Satianpong-Ded/Hydroponic_PCB/Hardware/BOM_Hydroponic.csv

ID | Name | Designator | Footprint | Quantity | Manufacturer Part | Manufacturer | Supplier | Supplier Part | Price
1 | 19-217/R6C-AL1M2VY/3T | LED1 | LED0603-RD | 1 | 19-217/R6C-AL1M2VY/3T | EVERLIGHT(亿光) | LCSC | C72044 | 0.021
2 | 10uF | C2,C5,C10 | CAP-TH_BD5.0-P2.00-D0.8-FD | 3 | 50YXF10MEFC5X11 | rubycon(红宝石) | LCSC | C88726 | 0.052
3 | 1uF | C11 | CAP-TH_BD5.0-P2.00-D0.8-FD | 1 | 50YXF10MEFC5X11 | rubycon(红宝石) | LCSC | C88726 | 0.052
4 | LED-TH-3mm_B | LED_B | LED-TH_BD3.0_BLUE | 1 | 204-10SUBC/S400-A4 | EVERLIGHT(台湾亿光) | LCSC | C86881 | 0.045
5 | CONN-TH_2P-P5.00 | RELAY_IN,12V_IN | CONN-TH_2P-P5.00 | 2 |  |  | LCSC
6 | 1uF | C4,C6,C8 | CAP-TH_L8.5-W5.0-P5.00-D1.2 | 3 | CT4-0805B105K500F3 | FH(风华) | LCSC | C94708 | 0.09
7 | 10uF | C7,C9 | CAP-TH_L5.5-W3.8-P5.08-D0.5 | 2 | CD1E106MC9BER2F100 | Dersonic(德尔创) | LCSC | C2761733 | 0.416
8 | 104 | CX1,CX2,CX3,CX4,CX5,CX6,CX7 | RAD-0.1 | 7 |  |  | YUJING
9 | 1N4007G_C232439 | D5,D6 | DO-41_BD2.4-L4.7-P8.70-D0.9-RD | 2 | 1N4007G | onsemi(安森美) | LCSC | C232439 | 0.057
10 | HDR-F-2.54_1x4 | DHT22 | HDR-F-2.54_1X4 | 1 |  |  | LCSC | C225501 | 0.098
11 | 2N3904BU | Q5,Q6 | TO-92-3_L5.1-W4.1-P1.27-L | 2 | 2N3904BU | onsemi(安森美) | LCSC | C124482 | 0.102
12 | 1k | R2,R10,R12,R13,R18 | R0603 | 5
13 | 51k | R4,R29 | R0603 | 2
14 | 10k | R7,R11,R19,R20,R22,R23,R24,R27,R28 | R0603 | 9
15 | 20k | R9,R25,R26 | R0603 | 3
16 | 100kΩ | R3 | RES-TH_BD2.3-L6.5-P10.50-D0.5 | 1 | MF1/4W-100KΩ±1% T | CCO(千志电子) | LCSC | C119369 | 0.011
17 | 1kΩ | R8,R21 | RES-TH_BD2.3-L6.5-P10.50-D0.5 | 2 | MF1/4W-1KΩ±1% T | CCO(千志电子) | LCSC | C119324 | 0.011
18 | 10kΩ | R14,R17 | RES-TH_BD2.3-L6.5-P10.50-D0.5 | 2 | MF1/4W-10KΩ±1% T | CCO(千志电子) | LCSC | C119347 | 0.011
19 | 470Ω | R15,R16 | RES-TH_BD2.3-L6.5-P10.50-D0.5 | 2 | MF1/2WS-470Ω±1% T | CCO(千志电子) | LCSC | C129899 | 0.011
20 | 5.1kΩ | R33,R36 | RES-TH_BD2.3-L6.5-P10.50-D0.5 | 2 | MF1/4W-5.1KΩ±1%T52 | 华星机电 | LCSC | C714010 | 0.01
21 | 220 | R6 | R_AXIAL-0.4 | 1
22 | 4.7kΩ | R30,R34,R37 | RES-TH_BD2.4-L6.3-P10.30-D0.6 | 3 | MFR-25FBF52-4K7 | YAGEO(国巨) | LCSC | C1371435 | 0.022
23 | 12kΩ | R31,R32,R35,R38 | RES-TH_BD2.2-L6.5-P10.50-D0.6 | 4 | MF1/4W-12KΩ±1% T | CCO(千志电子) | LCSC | C119349 | 0.011
24 | BNC-KYWE-295-W4-N | RF1 | BNC-TH_BNC-KYWE-295-W4-N | 1 | BNC-KYWE-295-W4-N | SAMZO(三佐) | LCSC | C41416668 | 1.567
25 | - | RLY5,RLY6 | RELAY-TH_SRD-XXVDC-XL-C | 2 | SRD-05VDC-SL-C | 松乐 | LCSC | C35449 | 0.446
26 | R_3386P_EU | RP1,RP2,RP3 | RES-ADJ-TH_3386P | 3 |  |  | LCSC
27 | VX7805-1000 voltage regulator | U1 | VX7805-1000 | 1 | VX7805-1000 | CUI | Digi-Key | 102-4253-ND
28 | AP2112K-3.3TRG1 | U4 | SOT-25-5_L2.9-W1.6-P0.95-LS2.8-BL | 1 | AP2112K-3.3TRG1 | DIODES(美台) | LCSC | C51118 | 0.179
29 | LTL17KRH5D-012A | U6,U7 | LED-TH_BD3.8-P2.54-RD-RED | 2 | LTL17KRH5D-012A | LITEON(光宝) | LCSC | C7435538 | 0.035
30 | TL431ACLPRE3 | U11 | TO-92-3_L4.8-W3.7-P1.27-L | 1 | TL431ACLPRE3 | TI(德州仪器) | LCSC | C2156646
31 | 100nF | U14,U16 | CAP-TH_L5.8-W2.8 | 2 | CC1H104MC1FD3F6C10SA | Dersonic(德尔创) | LCSC | C5375966 | 0.027
32 | ESP32-S3-WROOM-1(N8R2) | U15 | WIRELM-SMD_ESP32-S3-WROOM-1 | 1 | ESP32-S3-WROOM-1-N8R2 | ESPRESSIF(乐鑫) | LCSC | C2913204 | 4.678
33 | - | USB1 | USB-C-TH_TYPEC-306DDW-ARP16 | 1 | TYPEC-306DDW-ARP16 | XUNPU(讯普) | LCSC | C2840393 | 0.852
34 | TLV2372IDGKG4 | U2,U5,U8,U9,U10,U13 | VSSOP-8_L3.0-W3.0-P0.65-LS5.0-BL | 6 | TLV2372IDGKG4 | TI(德州仪器) | LCSC | C1347919 | 1.795
35 | SH-6X6X8H-CJ | BOOT,RESET | SW-TH_4P-L6.0-W6.0-P4.50-LS6.5_EVQPAE07K | 2 | SH-6X6X8H-CJ | SHOU HAN(首韩) | LCSC | C42416249 | 0.024
36 | HS96L03W2C03 | OLED_I2C | OLED-TH_L27.8-W27.2-P2.54_C9900033791 | 1 | HS96L03W2C03 | HS(汉昇) | LCSC | C5248080 | 2.362
37 | 1N4007 Tube | LED_R | DO-41_BD2.4-L4.7-P8.70-D0.9-RD | 1 | 1N4007 编带 | MDD(辰达半导体) | LCSC | C19357 | 0.022
38 | HDR-F-2.54_1x6 | PH_4502C | HDR-F-2.54_1X6 | 1 |  |  | LCSC | C40877 | 0.089
