Satianpong-Ded/Hydroponic_PCB/(commit log)

2026-10-19 README
    Added detailed README for Hydroponic PCB project including features, schematics, pin mapping, bill of materials, firmware instructions, and known issues.
2026-10-19 Create schematic
2026-10-19 Schematic files and circuit diagrams.
